abzman/r6501q/R6501Q SBC/R6501Q SBC.kicad_pcb

## KiCad design R6501Q SBC/R6501Q SBC.kicad_pcb (2022-07-23)

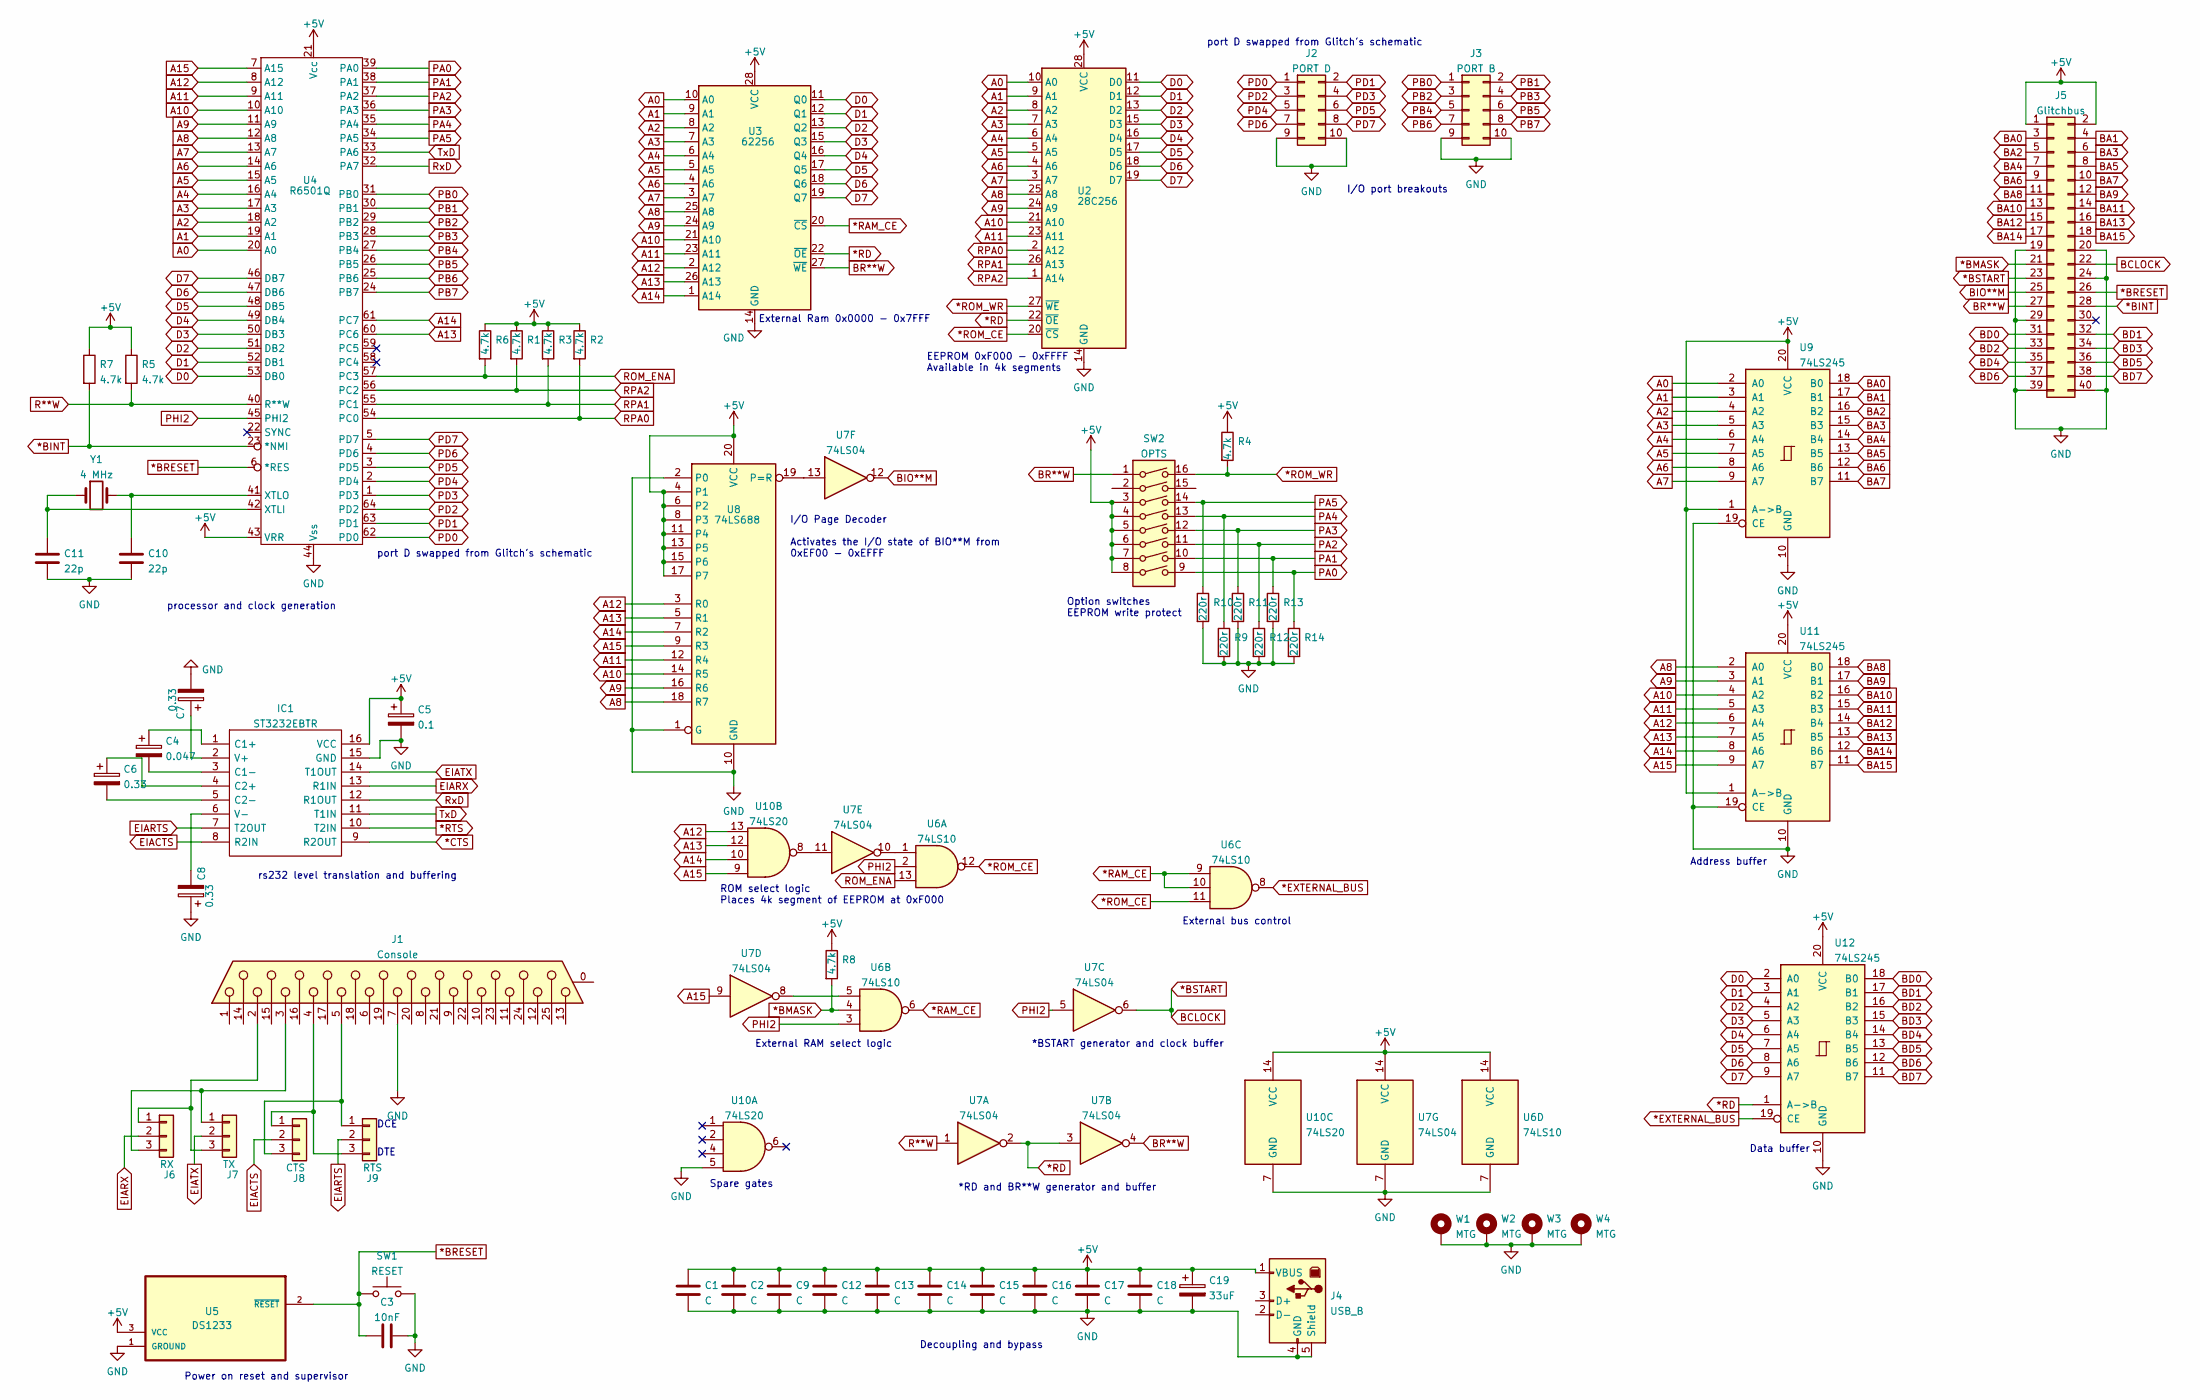
[picture p1: schematic R6501Q SBC.kicad_sch]

Parts:
C1, C2, C9, C12, C13, C14, C15, C16, C17, C18: C; C_0603_1608Metric
C3: 10nF; C_0603_1608Metric
C4: 0.047; C_0603_1608Metric
C5: 0.1; C_0603_1608Metric
C6, C7, C8: 0.33; C_0603_1608Metric
C10, C11: 22p; C_0603_1608Metric
C19: 33uF; CP_Radial_D6.3mm_P2.50mm
IC1: ST3232EBTR; SOP65P640X120-16N; Mouser Part Number 511-ST3232EB
J1: Console; amphenol db25
J2: PORT D; PinHeader_2x05_P2.54mm_Vertical
J3: PORT B; PinHeader_2x05_P2.54mm_Vertical
J4: USB_B; USB_B_OST_USB-B1HSxx_Horizontal
J5: Glitchbus; PinHeader_2x20_P2.54mm_Vertical
J6: RX; PinHeader_1x03_P2.54mm_Vertical
J7: TX; PinHeader_1x03_P2.54mm_Vertical
J8: CTS; PinHeader_1x03_P2.54mm_Vertical
J9: RTS; PinHeader_1x03_P2.54mm_Vertical
R1, R2, R3, R4, R5, R6, R7, R8: 4.7k; R_0603_1608Metric
R9, R10, R11, R12, R13, R14: 220r; R_0603_1608Metric
SW1: RESET; SW_Tactile_SPST_Angled_PTS645Vx39-2LFS
SW2: OPTS; SW_DIP_SPSTx08_Slide_9.78x22.5mm_W7.62mm_P2.54mm
U2: 28C256; DIP-28_W15.24mm
U3: 62256; DIP-28_W15.24mm
U4: R6501Q; QUIP64
U5: DS1233; TO92127P495H695-3
U6: 74LS10; DIP-14_W7.62mm
U7: 74LS04; DIP-14_W7.62mm
U8: 74LS688; DIP-20_W7.62mm
U9, U11, U12: 74LS245; DIP-20_W7.62mm
U10: 74LS20; DIP-14_W7.62mm
W1, W2, W3, W4: MTG; MountingHole_3.2mm_M3_DIN965_Pad
Y1: 4 MHz; Crystal_HC49-U_Vertical

Connections:
*BINT: J5.28, R7.2, U4.23 (*NMI)
*BMASK: J5.21, R8.2, U6.4
*BRESET: C3.2, J5.26, SW1.2, U4.6 (*RES), U5.2 (~RESET)
*BSTART: J5.22, J5.23, U7.6
*CTS: IC1.9 (R2OUT)
*EXTERNAL_BUS: U6.8, U12.19 (CE)
*RAM_CE: U3.20 (~CS), U6.6, U6.9, U6.10
*RD: U2.22 (~OE), U3.22 (~OE), U7.2, U7.3, U12.1 (A->B)
*ROM_CE: U2.20 (~CS), U6.11, U6.12
*ROM_WR: R4.2, SW2.16, U2.27 (~WE)
*RTS: IC1.10 (T2IN)
+5V: C1.1, C2.1, C5.1, C9.1, C12.1, C13.1, C14.1, C15.1, C16.1, C17.1, C18.1, C19.1, IC1.16 (VCC), J4.1 (VBUS), J5.1, J5.2, R1.1, R2.1, R3.1, R4.1, R5.1, R6.1, R7.1, R8.1, SW2.3, SW2.4, SW2.5, SW2.6, SW2.7, SW2.8, U2.28 (VCC), U3.28 (VCC), U4.21 (Vcc), U4.43 (VRR), U5.3 (VCC), U6.14 (VCC), U7.14 (VCC), U8.4 (P1), U8.6 (P2), U8.8 (P3), U8.11 (P4), U8.13 (P5), U8.15 (P6), U8.17 (P7), U8.20 (VCC), U9.1 (A->B), U9.20 (VCC), U10.14 (VCC), U11.1 (A->B), U11.20 (VCC), U12.20 (VCC)
A0: U2.10 (A0), U3.10 (A0), U4.20 (A0), U9.2 (A0)
A1: U2.9 (A1), U3.9 (A1), U4.19 (A1), U9.3 (A1)
A2: U2.8 (A2), U3.8 (A2), U4.18 (A2), U9.4 (A2)
A3: U2.7 (A3), U3.7 (A3), U4.17 (A3), U9.5 (A3)
A4: U2.6 (A4), U3.6 (A4), U4.16 (A4), U9.6 (A4)
A5: U2.5 (A5), U3.5 (A5), U4.15 (A5), U9.7 (A5)
A6: U2.4 (A6), U3.4 (A6), U4.14 (A6), U9.8 (A6)
A7: U2.3 (A7), U3.3 (A7), U4.13 (A7), U9.9 (A7)
A8: U2.25 (A8), U3.25 (A8), U4.12 (A8), U8.18 (R7), U11.2 (A0)
A9: U2.24 (A9), U3.24 (A9), U4.11 (A9), U8.16 (R6), U11.3 (A1)
A10: U2.21 (A10), U3.21 (A10), U4.10 (A10), U8.14 (R5), U11.4 (A2)
A11: U2.23 (A11), U3.23 (A11), U4.9 (A11), U8.12 (R4), U11.5 (A3)
A12: U3.2 (A12), U4.8 (A12), U8.3 (R0), U10.13, U11.6 (A4)
A13: U3.26 (A13), U4.60 (PC6), U8.5 (R1), U10.12, U11.7 (A5)
A14: U3.1 (A14), U4.61 (PC7), U8.7 (R2), U10.10, U11.8 (A6)
A15: U4.7 (A15), U7.9, U8.9 (R3), U10.9, U11.9 (A7)
BA0: J5.3, U9.18 (B0)
BA1: J5.4, U9.17 (B1)
BA2: J5.5, U9.16 (B2)
BA3: J5.6, U9.15 (B3)
BA4: J5.7, U9.14 (B4)
BA5: J5.8, U9.13 (B5)
BA6: J5.9, U9.12 (B6)
BA7: J5.10, U9.11 (B7)
BA8: J5.11, U11.18 (B0)
BA9: J5.12, U11.17 (B1)
BA10: J5.13, U11.16 (B2)
BA11: J5.14, U11.15 (B3)
BA12: J5.15, U11.14 (B4)
BA13: J5.16, U11.13 (B5)
BA14: J5.17, U11.12 (B6)
BA15: J5.18, U11.11 (B7)
BD0: J5.31, U12.18 (B0)
BD1: J5.32, U12.17 (B1)
BD2: J5.33, U12.16 (B2)
BD3: J5.34, U12.15 (B3)
BD4: J5.35, U12.14 (B4)
BD5: J5.36, U12.13 (B5)
BD6: J5.37, U12.12 (B6)
BD7: J5.38, U12.11 (B7)
BIO**M: J5.25, U7.12
BR**W: J5.27, SW2.1, U3.27 (~WE), U7.4
D0: U2.11 (D0), U3.11 (Q0), U4.53 (DB0), U12.2 (A0)
D1: U2.12 (D1), U3.12 (Q1), U4.52 (DB1), U12.3 (A1)
D2: U2.13 (D2), U3.13 (Q2), U4.51 (DB2), U12.4 (A2)
D3: U2.15 (D3), U3.15 (Q3), U4.50 (DB3), U12.5 (A3)
D4: U2.16 (D4), U3.16 (Q4), U4.49 (DB4), U12.6 (A4)
D5: U2.17 (D5), U3.17 (Q5), U4.48 (DB5), U12.7 (A5)
D6: U2.18 (D6), U3.18 (Q6), U4.47 (DB6), U12.8 (A6)
D7: U2.19 (D7), U3.19 (Q7), U4.46 (DB7), U12.9 (A7)
EIACTS: IC1.8 (R2IN), J8.2
EIARTS: IC1.7 (T2OUT), J9.2
EIARX: IC1.13 (R1IN), J6.2
EIATX: IC1.14 (T1OUT), J7.2
GND: C1.2, C2.2, C3.1, C5.2, C7.2, C8.1, C9.2, C10.2, C11.2, C12.2, C13.2, C14.2, C15.2, C16.2, C17.2, C18.2, C19.2, IC1.15 (GND), J1.7, J1.MH1, J1.MH2, J2.9, J2.10, J3.9, J3.10, J4.4 (GND), J4.5 (Shield), J5.19, J5.20, J5.24, J5.29, J5.39, J5.40, R9.2, R10.2, R11.2, R12.2, R13.2, R14.2, SW1.1, U2.14 (GND), U3.14 (GND), U4.44 (Vss), U5.1 (GROUND), U6.7 (GND), U7.7 (GND), U8.1 (G), U8.2 (P0), U8.10 (GND), U9.10 (GND), U9.19 (CE), U10.5, U10.7 (GND), U11.10 (GND), U11.19 (CE), U12.10 (GND), W1.1, W2.1, W3.1, W4.1
unnamed: C4.1, IC1.1 (C1+)
unnamed: C4.2, IC1.3 (C1-)
unnamed: C6.1, IC1.4 (C2+)
unnamed: C6.2, IC1.5 (C2-)
unnamed: C7.1, IC1.2 (V+)
unnamed: C8.2, IC1.6 (V-)
unnamed: C10.1, U4.41 (XTLO), Y1.2
unnamed: C11.1, U4.42 (XTLI), Y1.1
unnamed: J1.2, J6.1, J7.3
unnamed: J1.3, J6.3, J7.1
unnamed: J1.4, J8.1, J9.3
unnamed: J1.5, J8.3, J9.1
unnamed: U6.1, U7.10
unnamed: U6.5, U7.8
unnamed: U7.13, U8.19 (P=R)
unnamed: U7.11, U10.8
PA0: R14.1, SW2.9, U4.39 (PA0)
PA1: R13.1, SW2.10, U4.38 (PA1)
PA2: R12.1, SW2.11, U4.37 (PA2)
PA3: R11.1, SW2.12, U4.36 (PA3)
PA4: R9.1, SW2.13, U4.35 (PA4)
PA5: R10.1, SW2.14, U4.34 (PA5)
PB0: J3.1, U4.31 (PB0)
PB1: J3.2, U4.30 (PB1)
PB2: J3.3, U4.29 (PB2)
PB3: J3.4, U4.28 (PB3)
PB4: J3.5, U4.27 (PB4)
PB5: J3.6, U4.26 (PB5)
PB6: J3.7, U4.25 (PB6)
PB7: J3.8, U4.24 (PB7)
PD0: J2.1, U4.62 (PD0)
PD1: J2.2, U4.63 (PD1)
PD2: J2.3, U4.64 (PD2)
PD3: J2.4, U4.1 (PD3)
PD4: J2.5, U4.2 (PD4)
PD5: J2.6, U4.3 (PD5)
PD6: J2.7, U4.4 (PD6)
PD7: J2.8, U4.5 (PD7)
PHI2: U4.45 (PHI2), U6.2, U6.3, U7.5
R**W: R5.2, U4.40 (R**W), U7.1
ROM_ENA: R6.2, U4.57 (PC3), U6.13
RPA0: R2.2, U2.2 (A12), U4.54 (PC0)
RPA1: R3.2, U2.26 (A13), U4.55 (PC1)
RPA2: R1.2, U2.1 (A14), U4.56 (PC2)
RxD: IC1.12 (R1OUT), U4.32 (PA7)
TxD: IC1.11 (T1IN), U4.33 (PA6)

Notes on the sheet:
port D swapped from Glitch's schematic
External RAM select logic
Spare gates
processor and clock generation
DCE
Power on reset and supervisor
DTE
Decoupling and bypass
Data buffer
External Ram 0x0000 - 0x7FFF
Address buffer
*BSTART generator and clock buffer
External bus control
EEPROM 0xF000 - 0xFFFF Available in 4k segments
I/O port breakouts
Option switches EEPROM write protect
rs232 level translation and buffering
*RD and BR**W generator and buffer
I/O Page Decoder Activates the I/O state of BIO**M from 0xEF00 - 0xEFFF
ROM select logic Places 4k segment of EEPROM at 0xF000

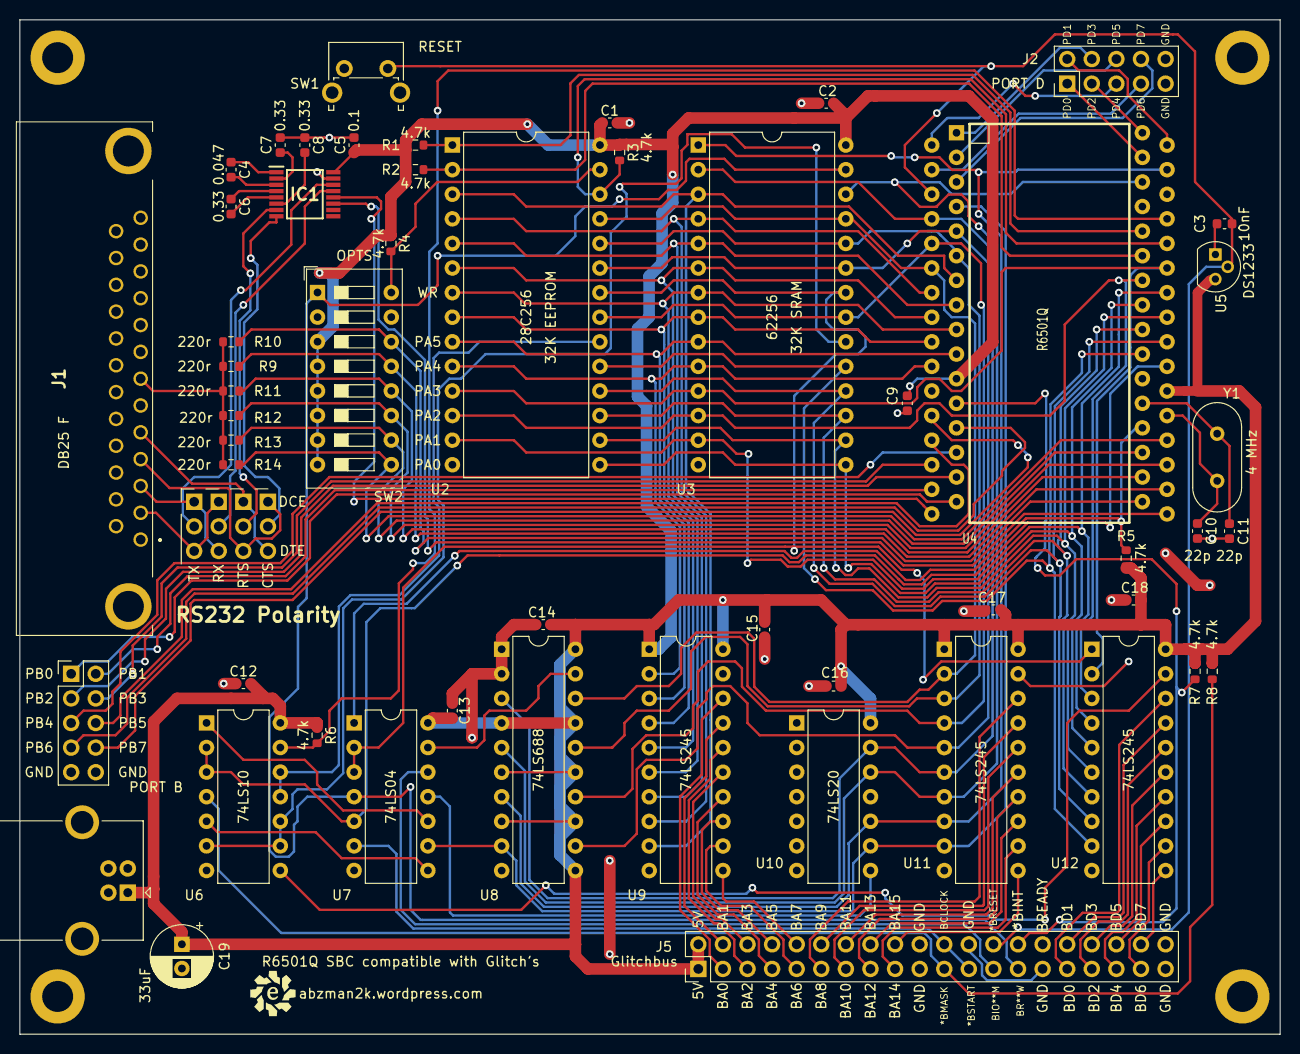
[picture p2: board R6501Q SBC.kicad_pcb from above]

Board: 2 copper layers, 130.2 x 104.8 mm, 61 parts (0 on the bottom side), 111 nets.
